KSturgis/SousVide-Arduino-PIDController/PIDcontroller/.PIDcontroller.vsarduino.h

#define __AVR_ATmega328P__
#define __cplusplus
#define __builtin_va_list int
#define __attribute__(x)
#define __inline__
#define __asm__(x)
#define ARDUINO 100
extern "C" void __cxa_pure_virtual() {}
void	setup();
void loop();

#include "C:\Users\Kippis\Desktop\arduino-1.0\hardware\arduino\variants\standard\pins_arduino.h" 
#include "C:\Users\Kippis\Desktop\arduino-1.0\hardware\arduino\cores\arduino\Arduino.h"
#include "J:\Projects\SousVide\PIDcontroller\PIDcontroller.ino" 
